gerardvalade/cnc-birdie/README.md

# cnc-birdie

CNC built with V-Slot rail and 3d printed gantry plate<br/>
<br/>
http://www.openbuilds.com/builds/birdie-cnc.1565/
<br/>
Used openscad library :<br/>
nophead/Mendel90  : https://github.com/nophead/Mendel90<br/>
fponticelli/smallbridges   :  https://github.com/fponticelli/smallbridges<br/>
JohK/nutsnbolts  : https://github.com/JohK/nutsnbolts<br/>

2016-05-14<br/>
Add antibackslash for T8 nut<br/>
Add TB650 holder<br/>

2015-06-08<br/>
Add cable chain<br/>

2015-05-26<br/>
Redesign Y axis plates<br/>
Belts holder reinforcements<br/>
Add X axis spacer for angular adjustement<br/>

2015-05-16<br/>
Optimize X axis position on Y axis frame<br/>
Simplify end stop holder<br/>
 
2015-04-26<br/>
Add CNCZAxisView<br/>
Add enstop adjust on z axis<br/>
Add belt tensionner<br/>
Correct some values<br/>
Change screw position on XAxisEndstopHolder old value can be found on XAxisEndstopHolder_deprecated

2015-04-18<br/>
Adding some more extractor (helpfull to remove plate from the glass).<br/>
Changing VSlotWheelSpacing20x40 value to 59.10mm.<br/>
Correct some spacing too small for printing.<br/>
Adding Y reference position to the upper of the wheel.<br/>
Adding partial brim.<br/>
Generate stl file.<br/>

2015-04-21<br/>
Adding parameter :<br/>
VSlotWheelSpacing20x40_X, VSlotWheelSpacing20x40_Y, VSlotWheelSpacing20x40_Z
