gerardvalade/cnc-birdie/png/cablechain1.png

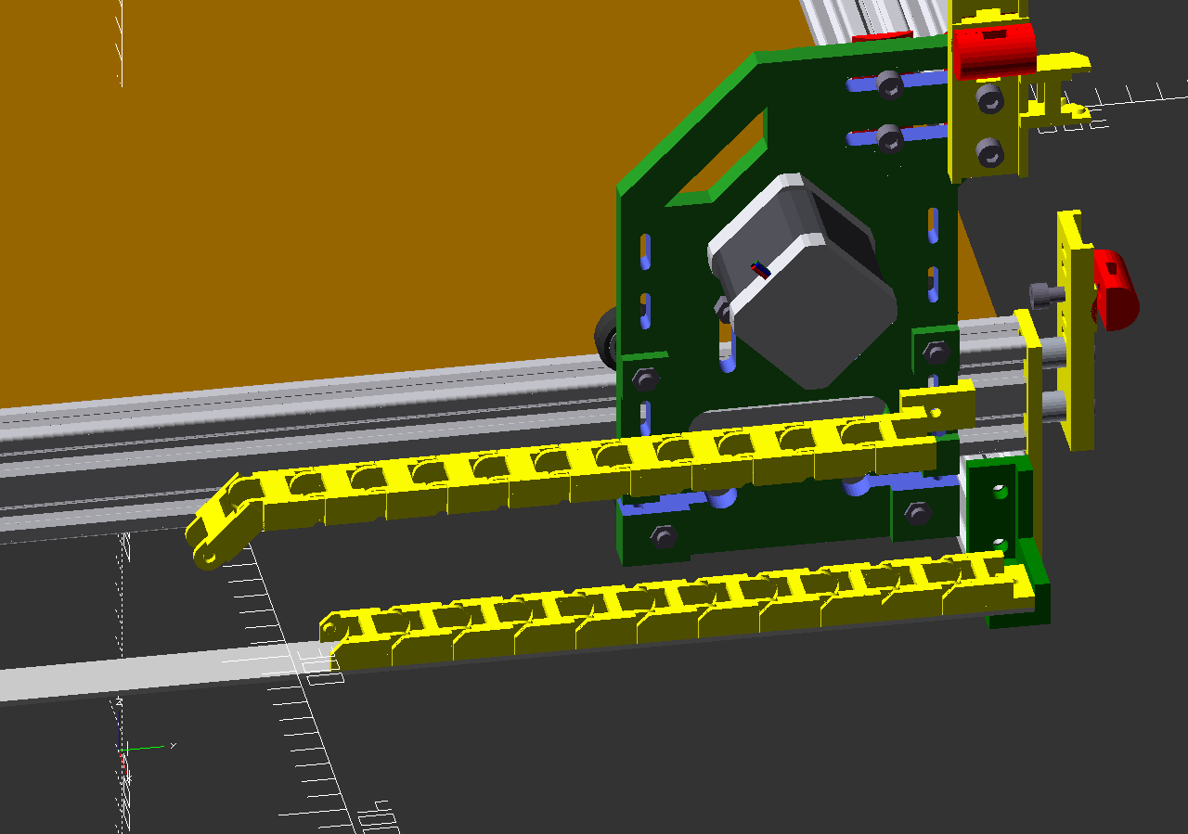
png/cablechain1.png
