gerardvalade/cnc-birdie/png/cablechain2.png

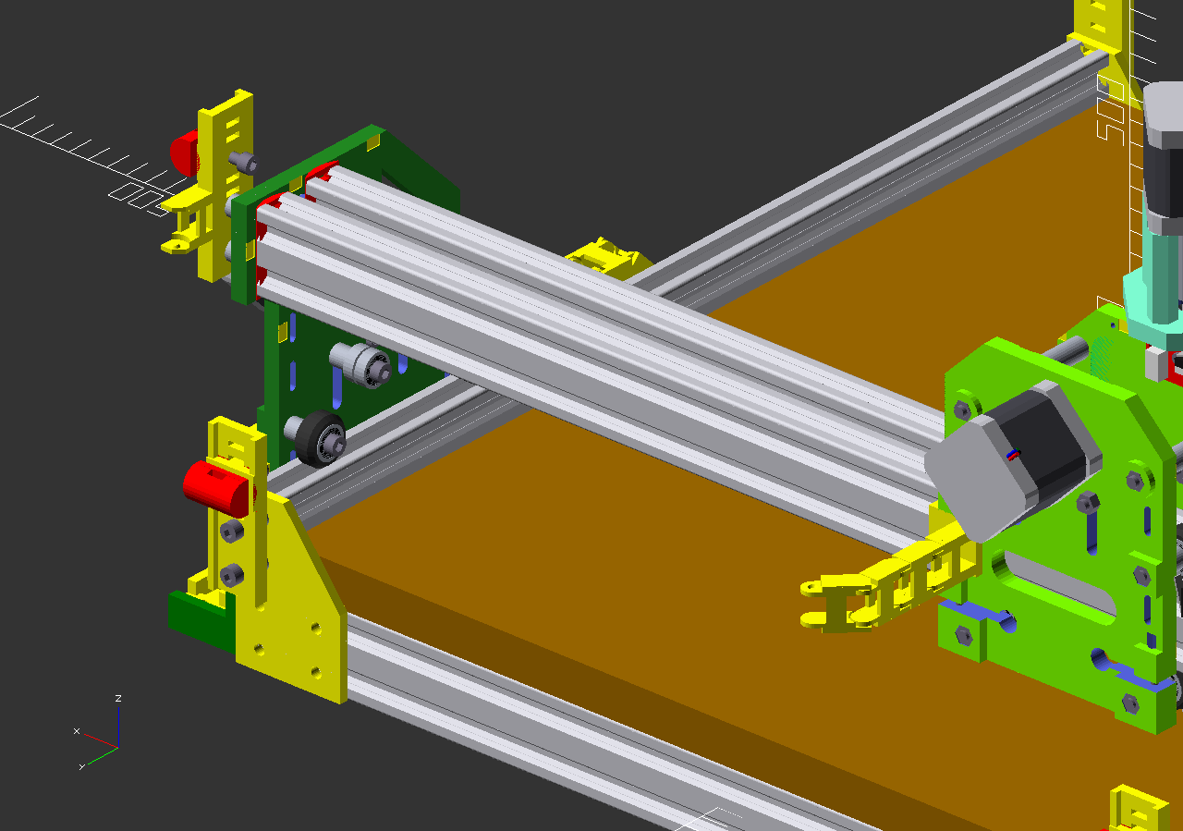
png/cablechain2.png
