gerardvalade/cnc-birdie/bill-of-materials.xlsx

Sheet: BillOfMaterials
[ Product Name ]
 | http://www.vertex42.com/ExcelTemplates/free-timesheet-template.html |  |  |  |  |  |  | © 2012-2014 Vertex42 LLC
 | Assembly Name : | Birdie CNC |  |  | [42] |  |  | Bill of Materials Template (http://www.vertex42.com/ExcelTemplates/bill-of-materials.html)
 | Assembly Number :
 | Assembly Revision :
 | Approval Date :
 | Part Count : | 314
 | Total Cost : | 50.70
Part # | Part Name | Description | Qty | Units | Picture | Unit Cost | Cost
 | endstop | Endstop | 3 |  |  | 2.00 | 6 €
 |  | Flexible Motor Shaft Coupler 25x8x31mm | 1 |  |  | 2.00 | 2 €
 |  | NEMA17 x 47mm stepper motor | 4 |  |  |  | 0 €
 |  | nut M2.5 | 4 |  |  |  | 0 €
 |  | nut M3 | 8 |  |  |  | 0 €
 |  | nut m5 | 30 |  |  |  | 0 €
 |  | nut M8 | 2 |  |  |  | 0 €
 |  | OpenBuild Ball Bearing 625 2RS | 52 |  |  |  | 0 €
 |  | OpenBuild Solid Wheel | 20 |  |  |  | 0 €
 |  | Plate XAxisBack (120mm x 142mm) | 1 |  |  |  | 0 €
 |  | Plate XAxisFront (120mm x 130mm) | 1 |  |  |  | 0 €
 |  | Plate YAxisLeft (120mm x 180mm) | 1 |  |  |  | 0 €
 |  | Plate YAxisRight (120mm x 180mm) | 1 |  |  |  | 0 €
 |  | Precision Shim 10x5x1mm | 26 |  |  |  | 0 €
 |  | Precision Shim 10x5x10mm | 26 |  |  |  | 0 €
 |  | Precision Shim 10x5x20mm | 4 |  |  |  | 0 €
 |  | Precision Shim 10x5x60mm | 2 |  |  |  | 0 €
 |  | T5 pulley 10 teeth | 3 |  |  |  | 0 €
 |  | Screw M2.5x16 | 12 |  |  |  | 0 €
 |  | Screw M3x16 | 19 |  |  |  | 0 €
 |  | Screw M3x20 | 18 |  |  |  | 0 €
 |  | Screw M3x25 | 2 |  |  |  | 0 €
 |  | Screw M5x10 | 16 |  |  |  | 0 €
 |  | Screw M5x20 | 18 |  |  |  | 0 €
 |  | Screw M5x30 | 6 |  |  |  | 0 €
 |  | Screw M5x35 | 18 |  |  |  | 0 €
 |  | Screw M5x80 | 6 |  |  |  | 0 €
 |  | Spacer 10x5x61mm | 2 |  |  |  | 0 €
 |  | Spring 12mm OD, 1.5mm gauge x 20mm long | 1 |  |  |  | 0 €
 |  | v-slot 20x40 (190mm) | 1 |  |  | 6.10 | 6.1 €
 |  | v-slot 20x40 (500mm) | 6 |  |  | 6.10 | 36.6 €
 | Total |  | 314 |  |  |  | 50.7 €

Sheet: Revisions
Revision History
 | Assembly Name :
 | Assembly Number :
Revision | Revision Summary | Approval Date

Sheet: Example
Bill of Materials for LEGO® Design
 |  |  | http://www.vertex42.com/ExcelTemplates/free-timesheet-template.html |  |  |  |  |  |  | © 2012-2014 Vertex42 LLC
 |  |  | Assembly Name : | Mini X-Wing™ |  |  | [42] |  |  | Bill of Materials Template (http://www.vertex42.com/ExcelTemplates/bill-of-materials.html)
 |  |  | Assembly Number : | Custom
 |  |  | Assembly Revision :
 |  |  | Approval Date :
 |  |  | Pieces : | 46
 |  |  | Total Cost : | $5.85
Category | Part # | Elem ID | Part Name | Color | Qty | Units | Picture | Unit Cost | Cost
Bricks, Sloping | 50746 | 4504369 | ROOF TILE 1X1X2/3, ABS | 1 - White | 1 | each |  | $0.10 | $0.10
Plates | 3024 | 302401 | PLATE 1X1 | 1 - White | 1 | each |  | $0.10 | $0.10
Plates | 3023 | 302301 | PLATE 1X2 | 1 - White | 2 | each |  | $0.10 | $0.20
Plates | 3023 | 4211398 | PLATE 1X2 | 194 - Medium Stone Grey | 1 | each |  | $0.10 | $0.10
Plates | 3794 | 379401 | PLATE 1X2 W. 1 KNOB | 1 - White | 1 | each |  | $0.10 | $0.10
Plates | 3623 | 362301 | PLATE 1X3 | 1 - White | 1 | each |  | $0.10 | $0.10
Plates | 3623 | 362321 | PLATE 1X3 | 21 - Bright Red | 1 | each |  | $0.10 | $0.10
Plates | 94148 | 302201 | PLATE 2X2 | 1 - White | 1 | each |  | $0.15 | $0.15
Plates, Special | 6141 | 4210633 | PLATE 1X1 ROUND | 199 - Dark Stone Grey | 1 | each |  | $0.10 | $0.10
Plates, Special | 3070 | 307021 | FLAT TILE 1X1 | 21 - Bright Red | 4 | each |  | $0.10 | $0.40
Plates, Special | 2412 | 241201 | RADIATOR GRILLE 1X2 | 1 - White | 1 | each |  | $0.10 | $0.10
Plates, Special | 6019 | 4538353 | PLATE 1X1 W/HOLDER VERTICAL | 1 - White | 4 | each |  | $0.15 | $0.60
Plates, Special | 2431 | 4558168 | FLAT TILE 1X4 | 1 - White | 1 | each |  | $0.20 | $0.20
Plates, Special | 63868 | 4535737 | PLATE 2X1 W/HOLDER,VERTICAL | 1 - White | 4 | each |  | $0.15 | $0.60
Plates, Special | 2540 | 4211632 | PLATE 1X2 W. STICK | 194 - Medium Stone Grey | 4 | each |  | $0.15 | $0.60
Plates, Special | 3176 | 4225733 | COUPLING PLATE 2X2 | 199 - Dark Stone Grey | 1 | each |  | $0.20 | $0.20
Bricks, Special | 49668 | 4224793 | PLATE 1X1 W/TOOTH | 5 - Brick Yellow | 1 | each |  | $0.10 | $0.10
Technic | 32123 | 4211573 | 1/2 BUSH | 194 - Medium Stone Grey | 4 | each |  | $0.10 | $0.40
Technic | 6590 | 4211622 | BUSH FOR CROSS AXLE | 194 - Medium Stone Grey | 8 | each |  | $0.15 | $1.20
Accessories | 3957 | 4211473 | STICK/AERIAL | 194 - Medium Stone Grey | 4 | each |  | $0.10 | $0.40
 |  |  | Total |  | 46 |  |  |  | $5.85

Sheet: ©
Bill of Materials Template
By Vertex42.com
http://www.vertex42.com/ExcelTemplates/bill-of-materials.html
© 2012-2014 Vertex42 LLC
This spreadsheet, including all worksheets and associated content is considered a copyrighted work under the United States and other copyright laws.
Do not submit copies or modifications of this template to any website or online template gallery.
Please review the following license agreement to learn how you may or may not use this template. Thank you.
See License Agreement (http://www.vertex42.com/licensing/EULA_privateuse.html)
http://www.vertex42.com/licensing/EULA_privateuse.html
Do not delete this worksheet. If necessary, you may hide it by right-clicking on the tab and selecting Hide.
