gerardvalade/cnc-birdie/stl/AntiBacklash.stl

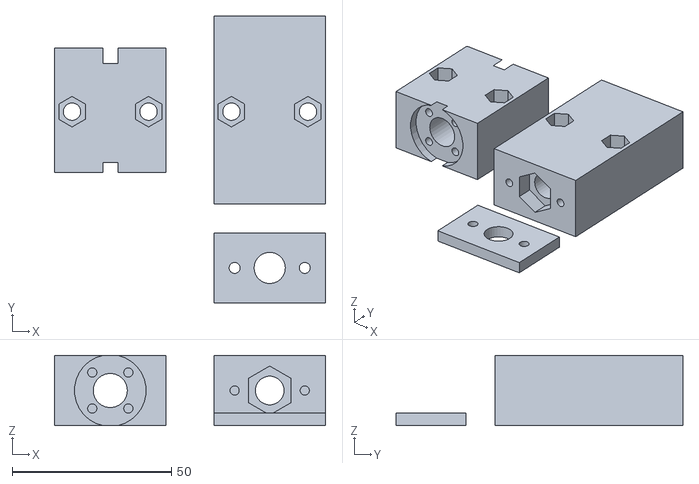
[picture p3: CAD file, 2016-05-14]
stl/AntiBacklash.stl
85.0 x 90.0 x 22.0
