gerardvalade/cnc-birdie/stl/CableChain.stl

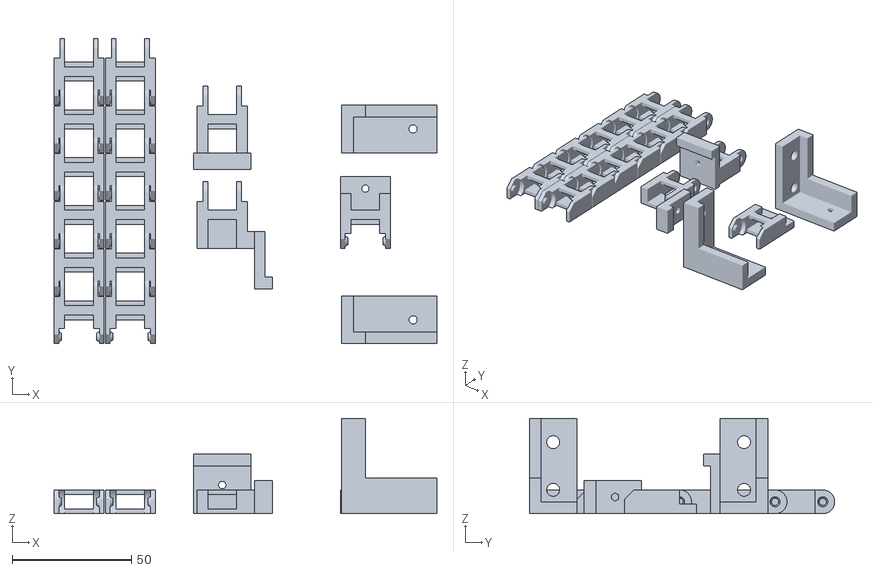
[picture p4: CAD file, 2015-06-08]
stl/CableChain.stl
160.5 x 128.0 x 40.0
