gerardvalade/cnc-birdie/stl/BeltHolder.stl

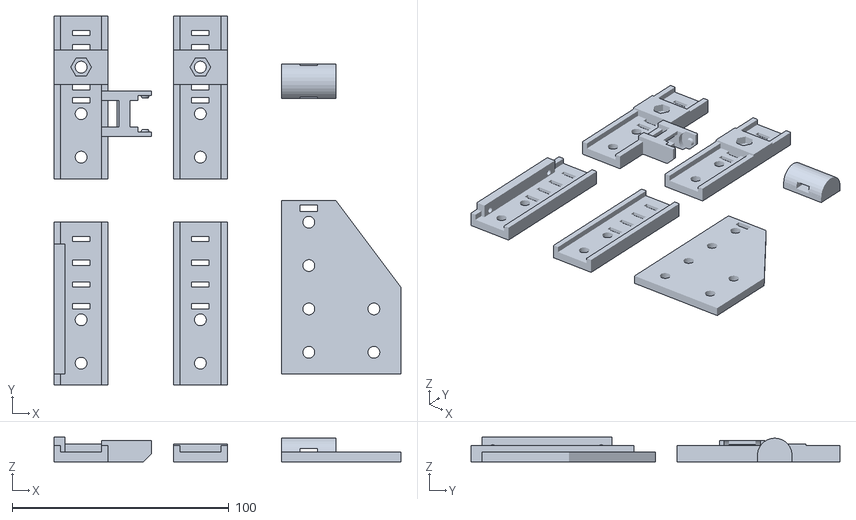
[picture p5: CAD file, 2015-06-08]
stl/BeltHolder.stl
160.0 x 170.0 x 11.5
