gerardvalade/cnc-birdie/stl/XAxisSpacer.stl

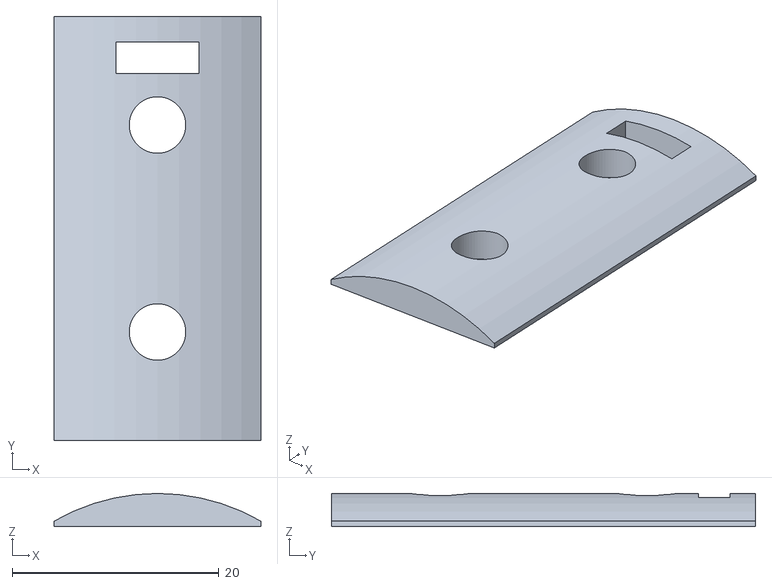
[picture p6: CAD file, 2015-06-08]
stl/XAxisSpacer.stl
20.0 x 41.0 x 3.20
