gerardvalade/cnc-birdie/stl/EndstopHolder.stl

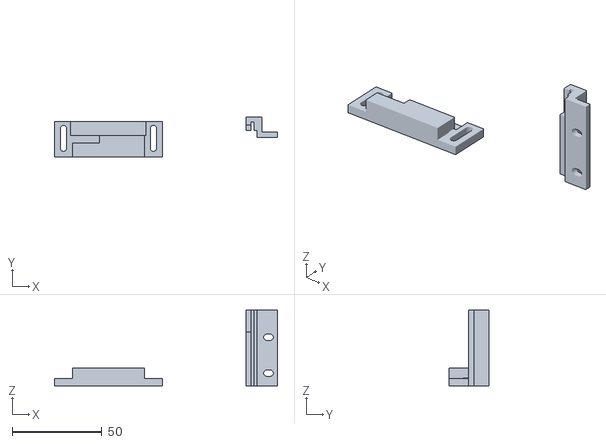
[picture p7: CAD file, 2015-05-26]
stl/EndstopHolder.stl
124.0 x 22.5 x 42.0
