gerardvalade/cnc-birdie/stl/PlateYAxisLeft.stl

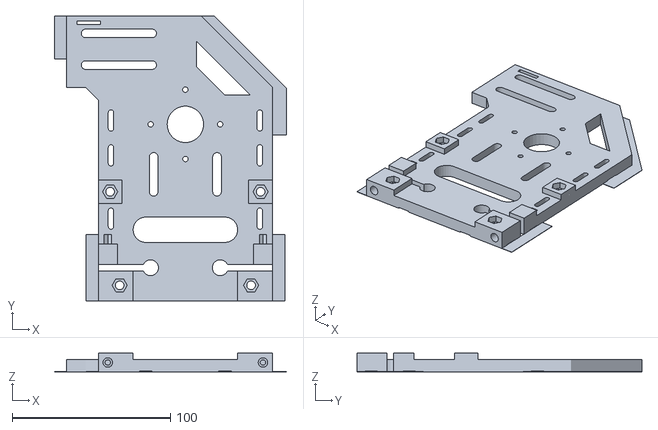
[picture p8: CAD file, 2015-05-26]
stl/PlateYAxisLeft.stl
146.8 x 180.0 x 12.0
