gerardvalade/cnc-birdie/stl/PlateXAxisBack.stl

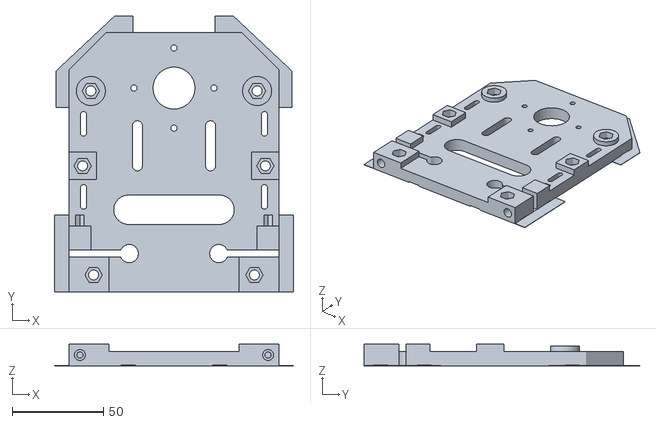
[picture p9: CAD file, 2015-05-26]
stl/PlateXAxisBack.stl
130.8 x 151.0 x 12.0
