gerardvalade/cnc-birdie/stl/ZAxisNemaHolder.stl

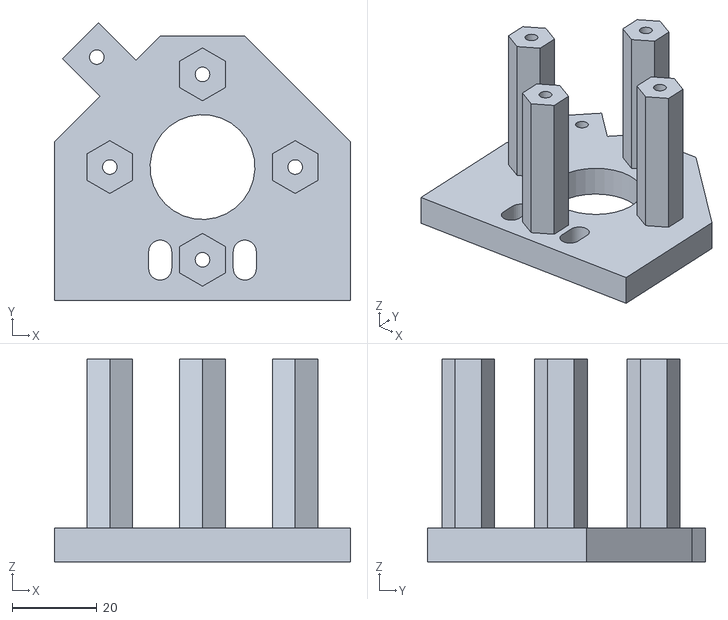
[picture p10: CAD file, 2015-05-26]
stl/ZAxisNemaHolder.stl
70.0 x 65.6 x 48.0
