gerardvalade/cnc-birdie/stl/PlateXAxisFront.stl

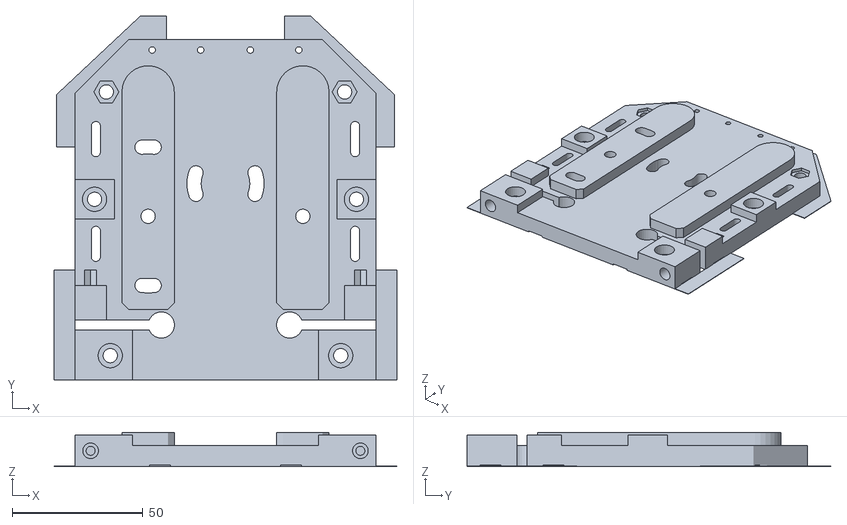
[picture p11: CAD file, 2015-05-26]
stl/PlateXAxisFront.stl
130.8 x 139.0 x 13.0
