gerardvalade/cnc-birdie/stl/ZAxisSpacer.stl

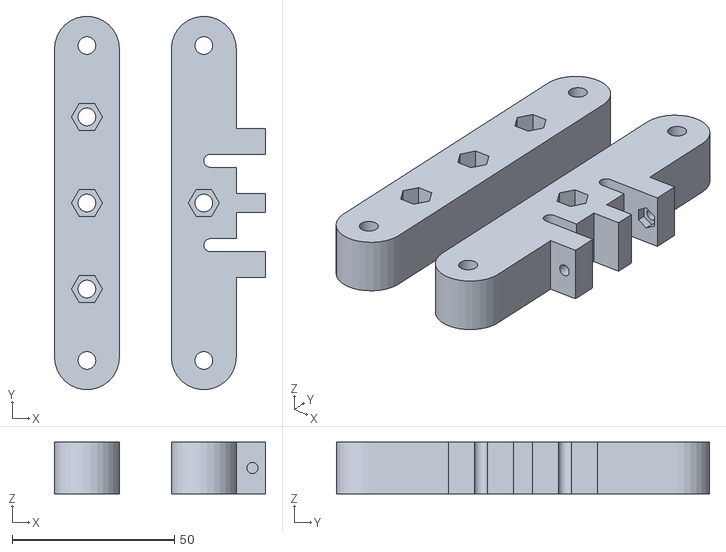
[picture p12: CAD file, 2015-05-26]
stl/ZAxisSpacer.stl
65.0 x 114.9 x 16.0
