gerardvalade/cnc-birdie/scad/bom.scad

module bom(code, desc, category) {
	echo(str("BOM: ",code," - ", desc, "; ", category));
}
