gerardvalade/cnc-birdie/(list of files, cad)

Other CAD files:
stl/PlateYAxisRight.stl
AntiBacklash.scad
BeltHolder.scad
CableChain.scad
CableChain_24.scad
CNCPlate.scad
CNCZAxisView.scad
EndstopHolder.scad
PlateXAxisBack.scad
PlateXAxisFront.scad
PlateYAxisLeft.scad
PlateYAxisRight.scad
XAxisSpacer.scad
ZAxisNemaHolder.scad
ZAxisSpacer.scad
scad/endstop.scad
stl/XAxisEndstopHolder.scad
TB6560/spacer.scad
scad/nutsnbolts/cyl_head_bolt.scad
scad/nutsnbolts/data-metric_cyl_head_bolts.scad
scad/nutsnbolts/examples.scad
scad/nutsnbolts/cyl_head_bolt-drawAllScript.scad
scad/nutsnbolts/data-access.scad
scad/nutsnbolts/materials.scad
scad/vitamins/ball-bearings.scad
scad/vitamins/bars.scad
scad/vitamins/belts.scad
scad/vitamins/bulldog.scad
scad/vitamins/cable_strip.scad
scad/vitamins/components.scad
scad/vitamins/d-connectors.scad
scad/vitamins/electronics.scad
scad/vitamins/fans.scad
scad/vitamins/hot_ends.scad
scad/vitamins/jhead_hot_end.scad
scad/vitamins/light_strips.scad
scad/vitamins/linear-bearings.scad
scad/vitamins/m90_hot_end.scad
scad/vitamins/microswitch.scad
scad/vitamins/nuts.scad
scad/vitamins/o_rings.scad
scad/vitamins/pillars.scad
scad/vitamins/pullies.scad
scad/vitamins/screws.scad
scad/vitamins/sheet.scad
scad/vitamins/spools.scad
scad/vitamins/springs.scad
scad/vitamins/stepper-motors.scad
scad/vitamins/stoffel_hot_end.scad
scad/vitamins/terminals.scad
scad/vitamins/tubing.scad
scad/vitamins/washers.scad
scad/vitamins/ziptie.scad
