gerardvalade/cnc-birdie/(commit log)

2015-02-08 redraw small brim
    [PlateAxis.scad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]
2015-02-08 add extractor
    [PlateAxis.scad, PlateXAxisBack.scad]
2015-02-11 remove minkowski
    [CNCProject.scad, PlateAxis.scad, PlateUtils.scad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]
2015-02-22 update drawExtractor
    [CNCProject.scad, PlateAxis.scad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]
2015-03-04 Correct nema 17 hole
    [PlateAxis.scad, PlateUtils.scad]
2015-03-04 correct nema17 hole
    [PlateYAxisLeft.stl]
2015-03-11 Change name fixing on Z axis
    [BeltHolder.scad, CNCProject.scad, PlateAxis.scad, PlateUtils.scad, PlateYAxisLeft.stl, ZAxisNemaHolder.scad, data-metric_cyl_head_bolts.scad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]
2015-03-21 coorect hole on ZAxisPlateMotorHolder
    [PlateAxis.scad, ZAxisNemaHolder.scad]
2015-04-18 Adding some more extractor. Changing VSlotWheelSpacing20x40 value. Correct some spacing too small for printing. Adding Y reference position to the upper of the wheel.
    [AntiBacklash.stl, BeltHolder.stl, CNCProject.scad, PlateAxis.scad, PlateUtils.scad, PlateXAxisBack.scad, PlateXAxisBack.stl, PlateXAxisFront.stl]
2015-04-21 dding parameter : VSlotWheelSpacing20x40_X
    [PlateAxis.scad, PlateUtils.scad]
2015-04-25 Add enstop adjust on z axis Add belt tensionner
    [BeltHolder.scad, BeltHolder.stl, CNCProject.scad, CNCZAxisView.scad, EndstopHolder.scad, EndstopHolder.stl, PlateAxis.scad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]
2015-05-26 Redesign Y axis plates
    [AntiBacklash.stl, BeltHolder.scad, BeltHolder.stl, CNCProject.scad, EndstopHolder.scad, EndstopHolder.stl, PlateAxis.scad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]
2015-06-08 Add cable chain
    [BeltHolder.scad, BeltHolder.stl, CNCProject.scad, CableChain.scad, CableChain.stl, CableChain_24.scad, PlateAxis.scad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]
2016-05-14 Add antibackslash for T8 nut
    [AntiBacklash.scad, AntiBacklash.stl, CableChain.scad, PlateUtils.scad, anti_backslash.scad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]
2016-05-14 Add TB650 holder
    [spacer.scad, tb6560.scad, uploads_b1_42_93_45_97_X3-OrdBot_Mount.scad]
